areum514/homeIotSystem/README.md

# homeIotSystem
주제: 화재, 도난, 일산화탄소 등을 여러가지 센서들을 이용한 홈아이오티 시스템 구축
