areum514/homeIotSystem/final_.pptx

2019년도 2학기: IoT 시스템 설계

무선 종합 경보기

하드웨어: 김민수, 김태연
현관 모듈: 추교찬, 이아름
침실 모듈: 한찬솔, 이경민, 유현아

## Slide 2

CONTENTS

00 01 02 03

개요

- 문제 정의
- 전체 구성
- 데이터 교환 형식
<JSON>

Level 1

- 동작환경
- 구성
- 동작방법

Level 2

- 동작환경
- 구성
- 동작방법

Level 3

- 동작환경
- 구성
- 동작방법

## Slide 3

IoT 시스템 설계 – 무성 종합 경보기

00

개요

## Slide 4

(1) 문제 정의

00

IoT 시스템 설계 – 무성 종합 경보기

북한 건물 내부에서
각종 위험 상황들을 감지하고
사용자에게 전파할 수 있는
시스템의 구축

## Slide 5

(2) 전체 구성

00

IoT 시스템 설계 – 무성 종합 경보기

MQTT

Hass

Raspberry Pi3

IFTTT

AP

Internet

NodeMCU #1
<거실, Room1>

문 열림 감지 센서, 불꽃 감지 센서, Button, LED, Buzzer

NodeMCU #2
<침실, Room2>

온습도 센서, 가스 센서, LCD, LED, Button, Buzzer

Notes: ‘NodeMCU #2’ 역시 ‘NodeMCU #1’과 동일하게 외출 모드 ON/OFF 하기 위해 Button을 추가하였다.

## Slide 6

(3) 데이터 교환 형식
webhook

00

IoT 시스템 설계 – 무성 종합 경보기

#define WEBHOOK_PROTOCOL "http://"

WEBHOOK_PROTOCOL 과 각각의 아이피틑 다음과 같이 정의 됩니다.
#define WEBHOOK_PROTOCOL "http://"

#define NODE2_IP “#.#.#.#”

#define NODE1_IP “#.#.#.#”

센서 | 변수
문 열림 감지 센서 | #define WEBHOOK_PATH_DOOROPEN WEBHOOK_PROTOCOL NODE2_IP "/DoorOpen/"
불꽃 감지 센서 | #define WEBHOOK_PATH_FLAME WEBHOOK_PROTOCOL NODE2_IP "/Flame/"
가스 센서 | #define WEBHOOK_PATH_GAS WEBHOOK_PROTOCOL NODE1_IP "/Gas/"
온도 센서 | #define WEBHOOK_PATH_TEMP WEBHOOK_PROTOCOL NODE1_IP "/Temperature/"
습도 센서 | #define WEBHOOK_PATH_HUMIDITY WEBHOOK_PROTOCOL NODE1_IP "/Humidity/”

Notes: #define WEBHOOK_PROTOCOL "http://"
#define NODE2_IP “#.#.#.#”

#define WEBHOOK_PROTOCOL "http://"
#define NODE1_IP "192.168.0.104"
" #define WEBHOOK_PATH_TEMP WEBHOOK_PROTOCOL NODE1_IP "/Temperature/" #define WEBHOOK_PATH_GAS WEBHOOK_PROTOCOL NODE1_IP "/Gas/"

#define WEBHOOK_PROTOCOL "http://"
#define NODE1_IP "192.168.0.104"

#define WEBHOOK_PATH_TEMP WEBHOOK_PROTOCOL NODE1_IP "/Temperature/"
#define WEBHOOK_PATH_GAS WEBHOOK_PROTOCOL NODE1_IP "/Gas/"

## Slide 7

IoT 시스템 설계 – 무성 종합 경보기

01

LEVEL

## Slide 8

LEVEL 1

01

IoT 시스템 설계 – 무성 종합 경보기

MQTT

Hass

Raspberry Pi3

IFTTT

AP

Internet

NodeMCU #1
<거실, Room1>

문 열림 감지 센서
불꽃 감지 센서

NodeMCU #2
<침실, Room2>

온습도 센서
가스 센서

Notes: 상황: 공유기 X, 인터넷 X
구성: NodeMCU 2개
동작 방식: 각 모듈이 독립적으로 동작

## Slide 9

NodeMCU #1: 메시지 포맷

01

IoT 시스템 설계 – 무성 종합 경보기

센서 | | lcd 화면에 출력되는 내용
문 열림 감지 센서 | 열림 | “DOOR OPEN!!”
| 닫힘 | "DOOR closed"
불꽃 감지 센서 | 감지 O | "FLAME undetected"
| 감지 X | "FLAME detected!"
푸시 버튼 | 사람 有 (외출모드X) | "Now inside. ***"
| 사람 無 (외출모드O) | "Now outside. ***"

Notes: #define DOOR_OPEN_MSG "DOOR OPEN!!"
#define DOOR_CLOSED_MSG "DOOR closed"
#define FLAME_UNDETECTED_MSG "FLAME undetected"
#define FLAME_DETECTED_MSG "FLAME detected!"

## Slide 10

NodeMCU #1: 불꽃 감지 센서 메시지에 의한 컴포넌트 동작(LED, Buzzer)

센서 상태 | | Description
| | 외출 모드 OFF (사람 有) | | 외출 모드 ON (사람 無)
| | LED | Buzzer | LED | Buzzer
문열림 | Detected | ON | Buzzer mode1: tone(Buzzer, 262, 100); | ON | Buzzer mode1: tone(Buzzer, 262, 100);
| Undetcted | OFF | OFF | OFF | OFF
화재 | Detected | ON | Buzzer mode2: tone(Buzzer, 131, 100); tone(Buzzer, 262, 100); 0.5초 주기로 5동안 | ON | Buzzer mode2: tone(Buzzer, 131, 100); tone(Buzzer, 262, 100); 0.5초 주기 10동안
| Undetcted | OFF | OFF | OFF | OFF
동시에 | Detected | ON | Buzzer mode3: tone(Buzzer, 131, 100); tone(Buzzer, 262, 100); 0.2초 주기로 5동안 | ON | Buzzer mode3: tone(Buzzer, 131, buzzerinterval); tone(Buzzer, 262, buzzerinterval); 0.2초 주기로 10동안
| Undetcted | OFF | OFF | OFF | OFF

01

IoT 시스템 설계 – 무성 종합 경보기

Notes: ※ 외출 모드 OFF(사람 有)에는 ‘쿠킹 모드 ON’과 ‘쿠킹 모드 OFF’ 두 가지 경우로 나누어진다. ‘쿠킹 모드 ON’의 경우, 불꽃이 감지되면 LED가 켜지고 Buzzer는 1분마다 들어오는 메시지가 1시간동안 계속해서 {“RoomLocation”: value, FlameFlagState”: ”FlameFlagON”}일 때 3옥타브 ‘도’와 4옥타브 ‘도’를 0.5초 주기로 반복하여 출력한다. (중간에 한번이라도 {“RoomLocation”: (동일한) value, FlameFlagState”: “FlameFlagOFF”}가 들어오면 시간을 reset한다.) LED와 Buzzer는 {“RoomLocation”: (동일한) value, FlameFlagState”: “FlameFlagOFF”} 메시지가 수신되면 꺼진다.
※ 외출 모드 OFF(사람 有)이면서 ‘쿠킹 모드 OFF’일 때는 {“RoomLocation”: value, FlameFlagState”: ”FlameFlagON”}가 들어오면 바로 LED와 함께 Buzzer에서 소리가 출력된다. 이 역시 {“RoomLocation”: (동일한) value, FlameFlagState”: “FlameFlagOFF”} 메시지가 수신되면 꺼진다.
※ 외출 모드 ON (사람 無)에는 {“RoomLocation”: value, FlameFlagState”: ”FlameFlagON”} 메시지가 들어오면 LED는 계속 OFF된 상태로 있지만 Buzzer는 {“RoomLocation”: value, FlameFlagState”: ”FlameFlagON”} 이 들어온 시간부터 5분 동안 3옥타브 ‘도’와 4옥타브 ‘도’를 0.5초 주기로 반복하여 출력한다. 🡪 주변 사람들에게 집 안에서 문제가 발생했다는 것을 알리기 위함이다.

## Slide 11

NodeMCU #2: 메시지 포맷

센서 | | lcd 화면에 출력되는 내용
온습도 센서 | | display.print("Temp: "); display.print(temperature,1); display.println(" *C"); display.print("Hum: "); display.print(humidity,1); display.println(" %");
가스 센서 | LOW (150 미만) | display.println("GAS Detected!"); display.print("GAS: "); display.println(GAS_value); display.print("Normal < "); display.println(GAS_MIDDLE);
| MIDDLE (250 이상 350 미만)
| HIGH (350 이상)
푸시 버튼 | 사람 有 (외출모드X) | {“RoomLocation”: Room2, LeavingState”: “LeavingModeOFF”}
| 사람 無 (외출모드O) | {“RoomLocation”: Room2, LeavingState”: “LeavingModeON”}

01

IoT 시스템 설계 – 무성 종합 경보기

※ 가스 측정 데이터의 범위 설정 및 Level 설정: 150 미만=LOW, 150 이상 450 미만=MIDDLE, 450 이상=HIGH

Notes: ※ 가스 측정 데이터의 범위 설정 및 Level 설정
150 미만: LOW, 150 이상 450 미만: MIDDLE, 450 이상: HIGH

## Slide 12

NodeMCU #2: 메시지 확인 주기 (전송 X)

01

IoT 시스템 설계 – 무성 종합 경보기

컴포넌트 | 버튼이 눌러졌을 때 (눌러지지 않았을 때는 메시지 확인 X)
푸시 버튼 | No delay (버튼이 눌러지면 무조건 toggle)

센서 | 외출 모드 OFF (사람 O) | 외출 모드 ON (사람 X)
온습도 센서 | 5분 | 15분
가스 센서 | 1초 | 1초

NodeMCU #2
<침실, Room2>

메시지 확인

Notes: NodeMCU #2 자체적으로 조건을 판별하여 컴포넌트의 동작을 제어하는 주기는 위와 같이 설정한다.
AP가 없기에 메시지 데이터를 확인하여 출력을 갱신하여도 실제로 이것이 전송되지는 못한다.
level 2와 level 3에서도 같은 주기로 메시지를 확인하여 출력 데이터를 갱신한다.

## Slide 13

NodeMCU #2: 푸시 버튼 메시지의 의한 모드 변경

01

IoT 시스템 설계 – 무성 종합 경보기

메시지 종류 | Description
{“RoomLocation”: value, LeavingState”: “LeavingModeON”} | 외출 모드 ON
{“RoomLocation”: value, LeavingState”: “LeavingModeOFF”} | 외출 모드 OFF

## Slide 14

NodeMCU #2: 온습도 센서와 가스 센서 메시지에 의한 LED, Buzzer 동작

01

IoT 시스템 설계 – 무성 종합 경보기

메시지 종류 | | Description
| | 외출 모드 OFF | | 외출 모드 ON
| | LED | Buzzer | LED | Buzzer
{“RoomLocation”: value, ”Temperature”: value: “Humidity”: value} | | OFF | OFF | OFF | OFF
{“RoomLocation”: value, “GasValue”: value} | LOW | OFF | OFF | OFF | OFF
{“RoomLocation”: value, “GasValue”: value} | MIDDLE | ON | ON (3옥타브 도) | OFF | OFF
{“RoomLocation”: value, “GasValue”: value} | HIGH | ON | ON(4옥타브 도) | OFF | OFF

Notes: ※ {“RoomLocation”: value, “GasValue”: value} (150 이상의 value) 메시지에 의해 LED와 Buzzer가 ON되는 경우, {“RoomLocation”: (동일한) value, “GasValue”: value} (150 미만의 value) 메시지가 수신될 때까지 꺼지지 않는다.
※ {“RoomLocation”: value, “GasValue”: value}의 가스 측정 데이터에 따라 Buzzer에서 다른 종류의 소리가 나도록 한다. 음계는 일반 사람들이 구분하기 힘들기 때문에 소리의 주기로 결정한다. (2초 주기로 4옥타브 ‘도’ ON/OFF 반복해서 출력하면 ‘MIDDLE’ 상태이며, 0.3초마다 4옥타브 ‘도’의 ON/OFF를 반복하며 출력하면 ‘HIGH’ 상태이다.)

## Slide 15

NodeMCU #2: 푸시 버튼 메시지에 의한 LCD 동작

01

IoT 시스템 설계 – 무성 종합 경보기

메시지 종류 | Description
| LCD
{“RoomLocation”: value, LeavingState”: “LeavingModeON”} | 첫 번째 줄: 위치정보 (String) 두 번째 줄: “Leav. Mode On” | 5초 출력 후 꺼짐
{“RoomLocation”: value, LeavingState”: “LeavingModeOFF”} | 첫 번째 줄: 위치정보 (String) 두 번째 줄: “Leav. Mode Off” | 5초 출력 후 온습도

Notes: ※ {“RoomLocation”: value, LeavingState”: “LeavingModeON”}에 의해서 5초 동안 위치정보와 “Leaving Mode On” 메시지가 LCD에 출력된 다음, LCD 화면이 꺼진다. (사람 無)

※ {“RoomLocation”: value, LeavingState”: “LeavingModeOFF”}에 의해서 5초 동안 위치정보와 “Leaving Mode Off” 메시지가 LCD에 출력된 다음, 기본적으로 위치정보와 온습도 데이터가 LCD에 출력된다.

## Slide 16

NodeMCU #2: 온습도 센서와 가스 센서 메시지에 의한 LCD 동작

01

IoT 시스템 설계 – 무성 종합 경보기

메시지 종류 | | Description
| | 외출 모드 OFF (사람 有) | 외출 모드 ON (사람 無)
| | LCD | LCD
{“RoomLocation”: value, ”Temperature”: value: “Humidity”: value} 온도 데이터: .1f (자료형 float, 소수점 첫째 자리) 습도 데이터: .1f (자료형 float, 소수점 첫째 자리) | | 첫 번째 줄: 위치정보 (String) 두 번째 줄: “Temp. : 온도 ℃(소수점 첫째자리 float)” 세 번째 줄: “Hum. : 습도 %(소수점 첫째자리 float)” 네 번째 줄: “Leaving mode: OFF” | 출력 안함
{“RoomLocation”: value, “GasValue”: value} 가스 측정 데이터 자료형: integer | LOW | 첫 번째 줄: 위치정보 (String) 두 번째 줄: “Temp. : 온도 ℃ (소수점 첫째자리 float)” 세 번째 줄: “Hum. : 습도 %(소수점 첫째자리 float)”
{“RoomLocation”: value, “GasValue”: value} 가스 측정 데이터 자료형: integer | MIDDLE | 첫 번째 줄: 위치정보 (String) 두 번째 줄: “Gas is detected!” 세 번째 줄: “Gas: 측정 값(Integer)” 네 번째 줄: “Normal < 250”
{“RoomLocation”: value, “GasValue”: value} 가스 측정 데이터 자료형: integer | HIGH

## Slide 17

IoT 시스템 설계 – 무성 종합 경보기

02

LEVEL

## Slide 18

LEVEL 2

02

IoT 시스템 설계 – 무성 종합 경보기

MQTT

Hass

Raspberry Pi3

IFTTT

AP

Internet

NodeMCU #1
<거실, Room1>

문 열림 감지 센서
불꽃 감지 센서

Local Network

Webhook
HTTP GET CALLBACK

NodeMCU #2
<침실, Room2>

온습도 센서
가스 센서

Notes: 상황: 공유기 O, 인터넷 X
구성: 공유기, NodeMCU 2개
동작 방식: 공유기가 AP로 동작하여 Local network 형성
통신 방식: Webhook 으로 node간 통신
특징: 각 노드가 외부(상대 노드) 컴포넌트로부터 데이터를 읽어 와서 이를 출력한다.
==========================================================
정의 : Webhooks are "user-defined HTTP callbacks". They are usually triggered by some event, such as pushing code to a repository or a comment being posted to a blog.

한 마디로 사용자 정의 HTTP 메소드 콜백

Level 2 에서는 HTTP GET 콜백을 정의하여 노드가 서로 통신하게 됨

## Slide 19

Webhook을 이용한 Node 1, 2 통신 방법

02

IoT 시스템 설계 – 무성 종합 경보기

AP

Local Network

Webhook
HTTP GET CALLBACK

NodeMCU #1
<거실, Room1>
IP: 100.100.100.100

문 열림 감지 센서
불꽃 감지 센서

[Node 1 의 센서 감지 상황을 전달받기 위해]
- http://100.100.100.200/DoorOpen/{위치정보}
- http://100.100.100.200/Flame/{위치정보}

NodeMCU #2
<침실, Room2>
IP: 100.100.100.200

온습도 센서
가스 센서

[Node 2 의 센서 감지 상황을 전달받기 위해]
- http://100.100.100.100/Humidity/{위치정보}
- http://100.100.100.100/Temperature/{위치정보}
- http://100.100.100.100/Gas/{위치정보}

## Slide 20

NodeMCU #1,#2: 메시지 포맷 <Webhook 링크 호출>

02

IoT 시스템 설계 – 무성 종합 경보기

#define WEBHOOK_PROTOCOL "http://"

WEBHOOK_PROTOCOL 과 각각의 아이피틑 다음과 같이 정의 됩니다.
#define WEBHOOK_PROTOCOL "http://"

#define NODE2_IP “#.#.#.#”

#define NODE1_IP “#.#.#.#”

센서 | 변수
문 열림 감지 센서 | #define WEBHOOK_PATH_DOOROPEN WEBHOOK_PROTOCOL NODE2_IP "/DoorOpen/"
불꽃 감지 센서 | #define WEBHOOK_PATH_FLAME WEBHOOK_PROTOCOL NODE2_IP "/Flame/"
가스 센서 | #define WEBHOOK_PATH_GAS WEBHOOK_PROTOCOL NODE1_IP "/Gas/"
온도 센서 | #define WEBHOOK_PATH_TEMP WEBHOOK_PROTOCOL NODE1_IP "/Temperature/"
습도 센서 | #define WEBHOOK_PATH_HUMIDITY WEBHOOK_PROTOCOL NODE1_IP "/Humidity/”

센서 | 변수
문 열림 감지 센서 | #define WEBHOOK_PATH_DOOROPEN WEBHOOK_PROTOCOL NODE2_IP "/DoorOpen/"
불꽃 감지 센서 | #define WEBHOOK_PATH_FLAME WEBHOOK_PROTOCOL NODE2_IP "/Flame/"
가스 센서 | #define WEBHOOK_PATH_GAS WEBHOOK_PROTOCOL NODE1_IP "/Gas/"
온도 센서 | #define WEBHOOK_PATH_TEMP WEBHOOK_PROTOCOL NODE1_IP "/Temperature/"
습도 센서 | #define WEBHOOK_PATH_HUMIDITY WEBHOOK_PROTOCOL NODE1_IP "/Humidity/”

Notes: #define WEBHOOK_PROTOCOL "http://"
#define NODE2_IP “#.#.#.#”

#define WEBHOOK_PROTOCOL "http://"
#define NODE1_IP "192.168.0.104"
" #define WEBHOOK_PATH_TEMP WEBHOOK_PROTOCOL NODE1_IP "/Temperature/" #define WEBHOOK_PATH_GAS WEBHOOK_PROTOCOL NODE1_IP "/Gas/"

#define WEBHOOK_PROTOCOL "http://"
#define NODE1_IP "192.168.0.104"

#define WEBHOOK_PATH_TEMP WEBHOOK_PROTOCOL NODE1_IP "/Temperature/"
#define WEBHOOK_PATH_GAS WEBHOOK_PROTOCOL NODE1_IP "/Gas/"

## Slide 21

NodeMCU #1: 메시지 포맷 <Webhook 링크 호출>

http://100.100.100.200/****/{위치정보}

센서 | | 생성되는 메시지 (스트링) | 예시
문 열림 감지 센서 | 열림 /DoorOpen/ | {“RoomLocation”: value, DoorState”: ”DoopOpen”} | {“RoomLocation”: Room1, DoorState”: ”DoopOpen”}
| 닫힘 | {“RoomLocation”: value, DoorState”: ”DoorClose”} | {“RoomLocation”: Room1, DoorState”: ”DoorClose”}
불꽃 감지 센서 | 감지 O /Flame/ | {“RoomLocation”: value, FlameFlagState”: ”FlameFlagON”} | {“RoomLocation”:Room1, FlameFlagState”: ”FlameFlagON”}
| 감지 X | {“RoomLocation”: value, FlameFlagState”: “FlameFlagOFF”} | {“RoomLocation”: Room1, FlameFlagState”: “FlameFlagOFF”}
푸시 버튼 | 사람 有 (외출모드X) | {“RoomLocation”: value, LeavingState”: “LeavingModeOFF”} | {“RoomLocation”: Room1, LeavingState”: “LeavingModeOFF”}
| 사람 無 (외출모드O) | {“RoomLocation”: value, LeavingState”: “LeavingModeON”} | {“RoomLocation”: Room1, LeavingState”: “LeavingModeON”}
| 쿠킹모드 O | {“RoomLocation”: value, CookingState”: “CookingModeON”} | {“RoomLocation”: Room1, CookingState”: “CookingModeON”}
| 쿠킹모드 X | {“RoomLocation”: value, CookingState”: “CookingModeOFF”} | {“RoomLocation”: Room1, CookingState”: “CookingModeOFF”}

02

IoT 시스템 설계 – 무성 종합 경보기

## Slide 22

NodeMCU #2: 메시지 포맷 <Webhook 링크 호출>

http://100.100.100.100/****/{위치정보}

센서 | | 생성되는 메시지 (스트링) | 예시
온습도 센서 /Temperature/ /Humidity/ | | {“RoomLocation”: value, ”Temperature”: value: “Humidity”: value} 온도 데이터: .1f (자료형 float, 소수점 첫째 자리) 습도 데이터: .1f (자료형 float, 소수점 첫째 자리) | {“RoomLocation”: Room2, “Temperature”: 27.5: “Humidity”: 46.3}
가스 센서 /Gas/ | LOW (150 미만) | {“RoomLocation”: value, “GasValue”: value} 가스 측정 데이터 자료형: integer | {“RoomLocation”: Room2, “GasValue”: 38}
| MIDDLE (250 이상 350 미만) | {“RoomLocation”: value, “GasValue”: value} 가스 측정 데이터 자료형: integer | {“RoomLocation”: Room2, “GasValue”: 180}
| HIGH (350 이상) | {“RoomLocation”: value, “GasValue”: value} 가스 측정 데이터 자료형: integer | {“RoomLocation”: Room2, “GasValue”: 350}
푸시 버튼 | 사람 有 (외출모드X) | {“RoomLocation”: value, LeavingState”: “LeavingModeOFF”} | {“RoomLocation”: Room2, LeavingState”: “LeavingModeOFF”}
| 사람 無 (외출모드O) | {“RoomLocation”: value, LeavingState”: “LeavingModeON”} | {“RoomLocation”: Room2, LeavingState”: “LeavingModeON”}

02

IoT 시스템 설계 – 무성 종합 경보기

※ 가스 측정 데이터의 범위 설정 및 Level 설정: 150 미만=LOW, 150 이상 450 미만=MIDDLE, 450 이상=HIGH

Notes: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

## Slide 23

NodeMCU #1: 메시지 확인 및 전송 주기

02

IoT 시스템 설계 – 무성 종합 경보기

컴포넌트 | 버튼이 눌러졌을 때 (눌러지지 않았을 때는 메시지 확인 X)
푸시 버튼 | 1초

센서 | 외출 모드 OFF (사람 有) | 외출 모드 ON (사람 無)
문 열림 감지 센서 | 10초 | 1초

센서 | 쿠킹 모드 ON & 외출 모드 OFF | 쿠킹 모드 OFF & 외출 모드 OFF | 외출 모드 ON (자동으로 쿠킹 모드 OFF)
불꽃 감지 센서 | 1분 | 1분 | 30초

NodeMCU #1
<거실, Room1>
IP: 100.100.100.100

메시지 확인 및 전송

Notes: 메시지 확인 및 전송 주기 (NodeMCU #1와 NodeMCU #2 두 가지 모듈의 동작 제어를 위해
메시지를 확인하고 전송함)

※ Level 1에서의 주기와 같다. bottom-top 형태로 level2와 3에서도 계속해서 유지된다.
※ Level 2에서는 level 1의 기능에 주기마다 메시지를 전송하는 기능이 추가된다.

## Slide 24

NodeMCU #1: NodeMCU #2의 푸시 버튼 메시지에 의한 모드 설정 <내부 메시지에 의한 동작은 Level1 유지>

외출 모드 제어가 NodeMCU #1, #2를 가리지 않고 버튼 및 메시지를 통해 가능

02

IoT 시스템 설계 – 무성 종합 경보기

메시지 종류 | Description
{“RoomLocation”: value, LeavingState”: “LeavingModeON”} | 외출 모드 ON
{“RoomLocation”: value, LeavingState”: “LeavingModeOFF”} | 외출 모드 OFF

NodeMCU #1
<거실, Room1>
IP: 100.100.100.100

## Slide 25

NodeMCU #1: NodeMCU #2의 가스 센서 메시지에 의한 모드 설정 <내부 메시지에 의한 동작은 Level1 유지>

02

IoT 시스템 설계 – 무성 종합 경보기

메시지 종류 | | Description
| | 외출 모드 OFF | | 외출 모드 ON
| | LED | Buzzer | LED | Buzzer
{“RoomLocation”: value, ”Temperature”: value: “Humidity”: value} | | OFF | OFF | OFF | OFF
{“RoomLocation”: value, “GasValue”: value} | LOW | OFF | OFF | OFF | OFF
{“RoomLocation”: value, “GasValue”: value} | MIDDLE | ON | ON (3옥타브 도) | OFF | OFF
{“RoomLocation”: value, “GasValue”: value} | HIGH | ON | ON(4옥타브 도) | OFF | OFF

NodeMCU #1
<거실, Room1>
IP: 100.100.100.100

온습도는 의미 없으므로 제외

Notes: ※ 데이터 포맷은 NodeMCU #2 데이터 포맷 (15page) 참조
※ NodeMCU #1가 전달 받는 온습도 메시지는 의미가 없기 때문에 제외시킴.
※ 전체동작은 Level1에서 NodeMCU #2의 LED, Buzzer 동작과 동일

## Slide 26

NodeMCU #2: 메시지 확인 및 전송 주기

02

IoT 시스템 설계 – 무성 종합 경보기

컴포넌트 | 버튼이 눌러졌을 때 (눌러지지 않았을 때는 메시지 확인 X)
푸시 버튼 | No delay (버튼이 눌러지면 무조건 toggle)

센서 | 외출 모드 OFF (사람 O) | 외출 모드 ON (사람 X)
온습도 센서 | 5분 | 15분
가스 센서 | 1초 | 1초

NodeMCU #2
<침실, Room2>
IP: 100.100.100.200

메시지 확인 및 전송

Notes: 메시지 확인 및 전송 주기 (NodeMCU #1와 NodeMCU #2 두 가지 모듈의 동작 제어를 위해
메시지를 확인하고 전송함)

※ Level 1에서의 주기와 같다. bottom-top 형태로 level2와 3에서도 계속해서 유지된다.
※ Level 2에서는 level 1의 기능에 주기마다 메시지를 전송하는 기능이 추가된다.

## Slide 27

NodeMCU #2: NodeMCU #1의 푸시 버튼 메시지에 의한 모드 설정

02

IoT 시스템 설계 – 무성 종합 경보기

외출 모드 제어가 NodeMCU #2, #1을 가리지 않고 버튼 및 메시지를 통해 가능

메시지 종류 | Description
{“RoomLocation”: value, LeavingState”: “LeavingModeON”} | 외출 모드 ON
{“RoomLocation”: value, LeavingState”: “LeavingModeOFF”} | 외출 모드 OFF

NodeMCU #2
<침실, Room2>
IP: 100.100.100.200

Notes: ※ NodeMCU #2의 버튼 뿐만 아니라 NodeMCU #1의 버튼에 의해서 외출모드가 설정될 수 있음을 의미한다.
위의 예시를 통해 NodeMCU #1의 메시지로 NodeMCU #2의 외출 모드가 설정될 수 있음을 알 수 있다.

## Slide 28

NodeMCU #2: NodeMCU #1에서 오는 문 열림 센서 메시지에 의한 컴포넌트 동작 (LED, Buzzer)

02

IoT 시스템 설계 – 무성 종합 경보기

메시지 종류 | Description
| 외출 모드 OFF (사람 有) | | | 외출 모드 ON (사람 無)
| LED | Buzzer | | LED | Buzzer
{“RoomLocation”: value, DoorState”: ”DoopOpen”} | ON | 문 열림 시간 20분 미만 | OFF | OFF | OFF
| | 문 열림 시간 20분 이상 | ON
{“RoomLocation”: value, DoorState”: ”DoorClose”} | OFF | OFF | | OFF | OFF

NodeMCU #2
<침실, Room2>
IP: 100.100.100.200

침실이므로 경보 필요 없음

Notes: ※ 외출 모드 OFF(사람 有)에는 {“RoomLocation”: value, DoorState”: ”DoopOpen”} 메시지에 의해 LED와 Buzzer가 ON되는 경우, {“RoomLocation”: (동일한) value, DoorState”: ”DoorClose”} 메시지가 수신될 때까지 꺼지지 않는다.
※ NodeMCU #1의 경우에는 외출 모드 ON(사람 無)에는 {“RoomLocation”: value, DoorState”: ”DoopOpen”} 메시지에 의해 LED와 Buzzer가 ON되어 1분 동안 작동(경고 목적)하도록 했지만, NodeMCU #2는 침실이므로 굳이 LED와 Buzzer가 작동할 필요 없다.

## Slide 29

NodeMCU #2: NodeMCU #1에서 오는 불꽃 감지 센서 메시지에 의한 컴포넌트 동작 (LED, Buzzer)

Buzzer: 3 옥타브 ‘도’ 및 4 옥타브 ‘도’ 를 0.5초 주기로 반복하여 출력

02

IoT 시스템 설계 – 무성 종합 경보기

메시지 종류 | Description
| 외출 모드 OFF (사람 有) | | | | | 외출 모드 ON (사람 無)
| 쿠킹 모드 ON | | | 쿠킹 모드 OFF
| LED | Buzzer | | LED | Buzzer | LED | Buzzer
{“RoomLocation”: value, FlameFlagState”: ”FlameFlagON”} | ON | 불꽃 감지 시간 1시간 미만 | OFF | ON | ON | OFF | OFF
| | 불꽃 감지 시간 1시간 이상 | ON
{“RoomLocation”: value, FlameFlagState”: “FlameFlagOFF”} | OFF | OFF | | OFF | OFF | OFF | OFF

NodeMCU #2
<침실, Room2>
IP: 100.100.100.200

침실이므로 경보 역할 불가

Notes: ※ 전체동작은 NodeMCU #1과 비슷하게 동작, 14 page 참고
※ 메시지 포맷은 NodeMCU #1의 메시지 포맷 참고 (10 page)
※ 외출 모드 ON (사람 無)에는 {“RoomLocation”: value, FlameFlagState”: ”FlameFlagON”} 메시지가 들어오면 NodeMCU #1에서는 Buzzer를 울렸지만, NodeMCU #2는 침실이기 때문에 Buzzer를 울려서 주변 사람들에게 상황을 전파하는 역할을 할 수 없다. 고로 해당기능을 OFF 시켰다.

## Slide 30

NodeMCU #2: NodeMCU #1에서 오는 메시지에 의한 컴포넌트 동작 (LCD)

02

IoT 시스템 설계 – 무성 종합 경보기

메시지 종류 | Description
| LCD
{“RoomLocation”: value, LeavingState”: “LeavingModeON”} | 첫 번째 줄: 위치정보 (String) 두 번째 줄: “Leaving Mode On” | 5초 출력 후 꺼짐
{“RoomLocation”: value, LeavingState”: “LeavingModeOFF”} | 첫 번째 줄: 위치정보 (String) 두 번째 줄: “Leaving Mode Off” | 5초 출력 후 온습도

NodeMCU #1
<거실, Room1>
IP: 100.100.100.100

NodeMCU #2
<침실, Room2>
IP: 100.100.100.200

Notes: ※ {“RoomLocation”: value, LeavingState”: “LeavingModeON”}에 의해서 10초 동안 위치정보와 “Leaving Mode On” 메시지가 LCD에 출력된 다음, LCD 화면이 꺼진다. (사람 無)

※ {“RoomLocation”: value, LeavingState”: “LeavingModeOFF”}에 의해서 10초 동안 위치정보와 “Leaving Mode Off” 메시지가 LCD에 출력된 다음, 기본적으로 위치정보와 온습도 데이터가 LCD에 출력된다.

## Slide 31

NodeMCU #2: NodeMCU #1에서 오는 메시지에 의한 컴포넌트 동작(LCD)

메시지 종류 | Description
| 외출 모드 OFF (사람 有) | 외출 모드 ON
| LCD | LCD
{“RoomLocation”: value, DoorState”: ”DoopOpen”} | 첫 번째 줄: 위치정보 (String) 두 번째 줄: “Door is open!” 네 번째 줄: “Leaving mode: OFF” | 출력 안함
{“RoomLocation”: value, DoorState”: ”DoorClose”} | 첫 번째 줄: 위치정보 (String) 두 번째 줄: “Temperature: 온도(소수점 첫째자리 float)” 세 번째 줄: “Humidity: 습도(소수점 첫째자리 float)” 네 번째 줄: “Leaving mode: OFF”
{“RoomLocation”: value, FlameFlagState”: ”FlameFlagON”} | 첫 번째 줄: 위치정보 (String) 두 번째 줄: “Flame is detected!” 네 번째 줄: “Leaving mode: OFF”
{“RoomLocation”: value, FlameFlagState”: “FlameFlagOFF”} | 첫 번째 줄: 위치정보 (String) 두 번째 줄: “Temperature: 온도(소수점 첫째자리 float)” 세 번째 줄: “Humidity: 습도(소수점 첫째자리 float)” 네 번째 줄: “Leaving mode: OFF”

02

IoT 시스템 설계 – 무성 종합 경보기

## Slide 32

IoT 시스템 설계 – 무성 종합 경보기

03

LEVEL

## Slide 33

03

Broker

LEVEL 3

IoT 시스템 설계 – 무성 종합 경보기

MQTT

Hass

Subscriber

Raspberry Pi3

Topic

IFTTT

AP

Internet

Internet

Publisher

Publisher

NodeMCU #1
<거실, Room1>

문 열림 감지 센서
불꽃 감지 센서

NodeMCU #2
<침실, Room2>

온습도 센서
가스 센서

Notes: ‘NodeMCU #2’ 역시 ‘NodeMCU #1’과 동일하게 외출 모드 ON/OFF 하기 위해 Button을 추가하였다.
=====================================
node(publish data)
-> raspberrypi(broker)
-> HASS(subscribe&receive data)

Publisher 🡪 nodeMCU (정보를 만들어 내는 곳)
Broker 🡪 Rpi3 (정보를 중계하는 곳)
Subscriber 🡪 Hass (정보를 사용하는 곳)

PI IP에서 broker를 형성하여, node와 HASS간 데이터 전송을 주관한다.
Node 1, 2 각각 자신의 인터넷 연결 상태를 우선적으로 mqttbroker에 publish*한다.
이후, 자신의 데이터 확인 주기마다 mqtt broker에 publish한다.
HASS로 publish할 topic: data는 *39page*와 같이 구성한다.

## Slide 34

IFTTT: 전송 – 코드 설계

03

IoT 시스템 설계 – 무성 종합 경보기

Func: send_event(“Message”)

사고 상황 | 함수 | 알림
Door | send_event(“DoorFlaagon”) | DoorOpen = HIGH
Flame | Send_event (“FlameFlagon”) | FlamgeFlagOn = HIGH
Gas | Send_event(“GasFlagon”) | GasValue > 450

Notes: Send_event(“메시지”) 형태로 함수 만들어줌
전송된 json data의 두번째 value를 파라미터로 바로 passing 해준다.
가스의 경우 GasValue의 키 값이 450이상이면 알림이 울리게 내부에서 설정해준다
Ex)
도난 감지: Send_event (“DoorOpen”)
화재 감지: Send_event (“FlameFlagon”)
가스 감지: Send_event(“GasFlagon”)

## Slide 35

IFTTT: 전송 – 시간 조건 및 결과

03

IoT 시스템 설계 – 무성 종합 경보기

사고 상황 | Leaving mode: ON | Leaving mode: OFF
| 3분 마다 | 10분 마다
Gas | “가스 가 감지되었습니다.”
Door | “문열림이 감지되었습니다.”
Flame | “화재가 감지되었습니다.”

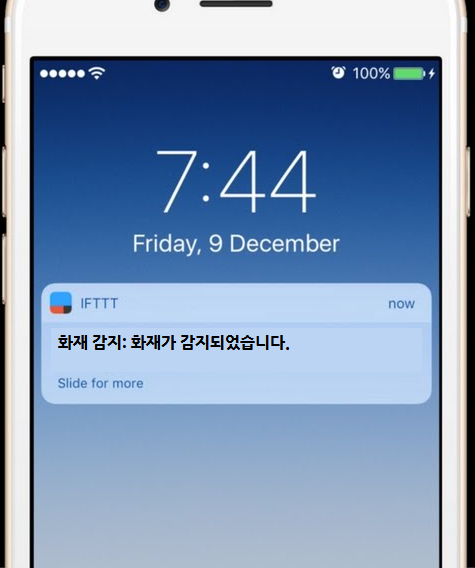
[picture p22: figure]

IFTTT

Notification

Notes: Buzzer/LED와 반대로, IFTTT는 외출 시 원격으로 사고 상황을 전달하는 것에 중점을 두기에 leaving mode: ON 일 경우 신호가 바뀔 때까지 3분마다 notification을 전송하여 상황을 전달한다.
아래 표는 send_event(“사고상황”)를 행하는 주기이다. 사고 상황이 HIGH가 지속되는 경우 해당 주기마다 notification을 전송한다.

## Slide 36

MQTT: topic

03

IoT 시스템 설계 – 무성 종합 경보기

Hass에서 switch를 만들어 LED와 Buzzer의 상태를 임의적으로 바꿀 수 있도록 함

Topics | nodeMCU #1 (publish) | nodeMCU #2 (publish) | HASS (subscribe)
topic (dht22_t) | X | myhome/room2/dht22_t | myhome/room2/dht22_t
topic (dht22_h) | X | myhome/room2/dht22_h | myhome/room2/dht22_h
topic (gas) | X | myhome/room2/gas | myhome/room2/gas
topic (door) | myhome/room1/door | x | myhome/room1/door
topic (Flame) | myhome/room1/flame | x | myhome/room1/flame
topic (wifi) | myhome/room1/wifi | myhome/room2/wifi | myhome/room1/wifi myhome/room2/wifi2

Topics | NodeMCU #1 (subscribe) | NodeMCU #2 (subscribe) | HASS(publish)
topic (LED/BUZZER) | myhome | myhome | myhome

## Slide 37

MQTT: HASS에서 publish하는 data

03

IoT 시스템 설계 – 무성 종합 경보기

Switch

Name == “LED”

Name == “Buzzer”

“ledon”
“ledoff”

Payload_on
Payload_off

“buzzeron”
“buzzeroff”

## Slide 38

MQTT: NodeMCU에서 publish하는 data

03

IoT 시스템 설계 – 무성 종합 경보기

Location | Message | DataType
NodeMCU #2 | myhome/room2/dht22_t: {temperature} | Float
| myhome/room2/dht22_h: {humidity} | Float
| myhome/room2/gas: {“Gas detected” or Gas undetected} | String
NodeMCU #1 | myhome/room1/door: {“DOOR Open” or “DOOR closed”} | String
| myhome/room1/flame: {“FLAME detected” or “FLAME undetectedf”} | String
AP | myhome/wifi: {“WIFI On” or “WIFI OFF”} myhome/wif2:{“WIFI On” or “WIFI OFF”} | String

Notes: - mqtt publish 할 때에는 위치 정보를 따로 value로 보내지는 않는다.
LEVEL 2에서 사용한 메시지의 State정보만을 보내준다.
온도, 습도 메시지 따로 전송

myhome/room2/dht22_t: {temperature} (float)
myhome/room2/dht22_h: {humidity} (float)
myhome/room2/gas: {gas} (integer)
myhome/room1/door: {“DoorOpen” or “DoorClosed”} (string)
myhome/room1/flame: {“FlameFlagOn” or “FlameFlagOff”} (string)
myhome/room1/mode: {“LeavingModeON” or “LeavingModeOFF”} (string)
myhome/wifi: {“Connected”} (string)
- mqtt는 internet이 연결되어야 사용할 수 있으므로, Connected 되었을 경우에만 publish 하여 연결 상태를 확인할 수 있도*록 한다.

## Slide 39

HASS: 명세

03

IoT 시스템 설계 – 무성 종합 경보기

Hass

Subscriber

NodeMCU #1
<거실, Room1>

NodeMCU #2
<침실, Room2>

Publisher

Publisher

main

Internet

Internet

MQTT

Raspberry Pi3

Broker

인터넷 미 연결 표시
최근 데이터 지속 표시

Notes: 3개의 탭으로 구성(main, Node#1 상세, node#2 상세)

Internet 조건
- 연결 시, PI broker를 통해 mqtt topic subscribe
- 미 연결 시, 인터넷이 미 연결 되어 있음을 표시해주고 가장 최근 데이터를 지속적으로 표시

Node에서 publish한 data를 수신하여 HASS 내부 데이터 구성

## Slide 40

HASS: mqtt subscribe에 따른 내부 data 정의

03

IoT 시스템 설계 – 무성 종합 경보기

Topic of the data | HASS
myhome/room2/dht22_t | Temperature
Myhome/room2/dht22_h | Humidity
myhome/room2/gas | Gas
myhome/room1/door | Door
myhome/room1/flame | Flame
myhome/room1/mode | Mode
myhome/room1/wifi myhome/room2/wifi2 | Wifi#1 / Wifi#2 Wifi value는 default로 “Disonnected”, mqtt로 연결되어 위 topic이 publish 됐을 때만 “Connected”

## Slide 41

HASS: main Tap – 구조

00

IoT 시스템 설계 – 무성 종합 경보기

Hass

main

(1) Wi-Fi 연결 상태 (#1 / #2)

(2) 온도와 습도

(3) 각 방의 상황

(5) 스위치

## Slide 42

IoT 시스템 설계 – 무성 종합 경보기

THANK
YOU

감사합니다
