areum514/homeIotSystem/diagram/node2_FLAGCHART.jpg

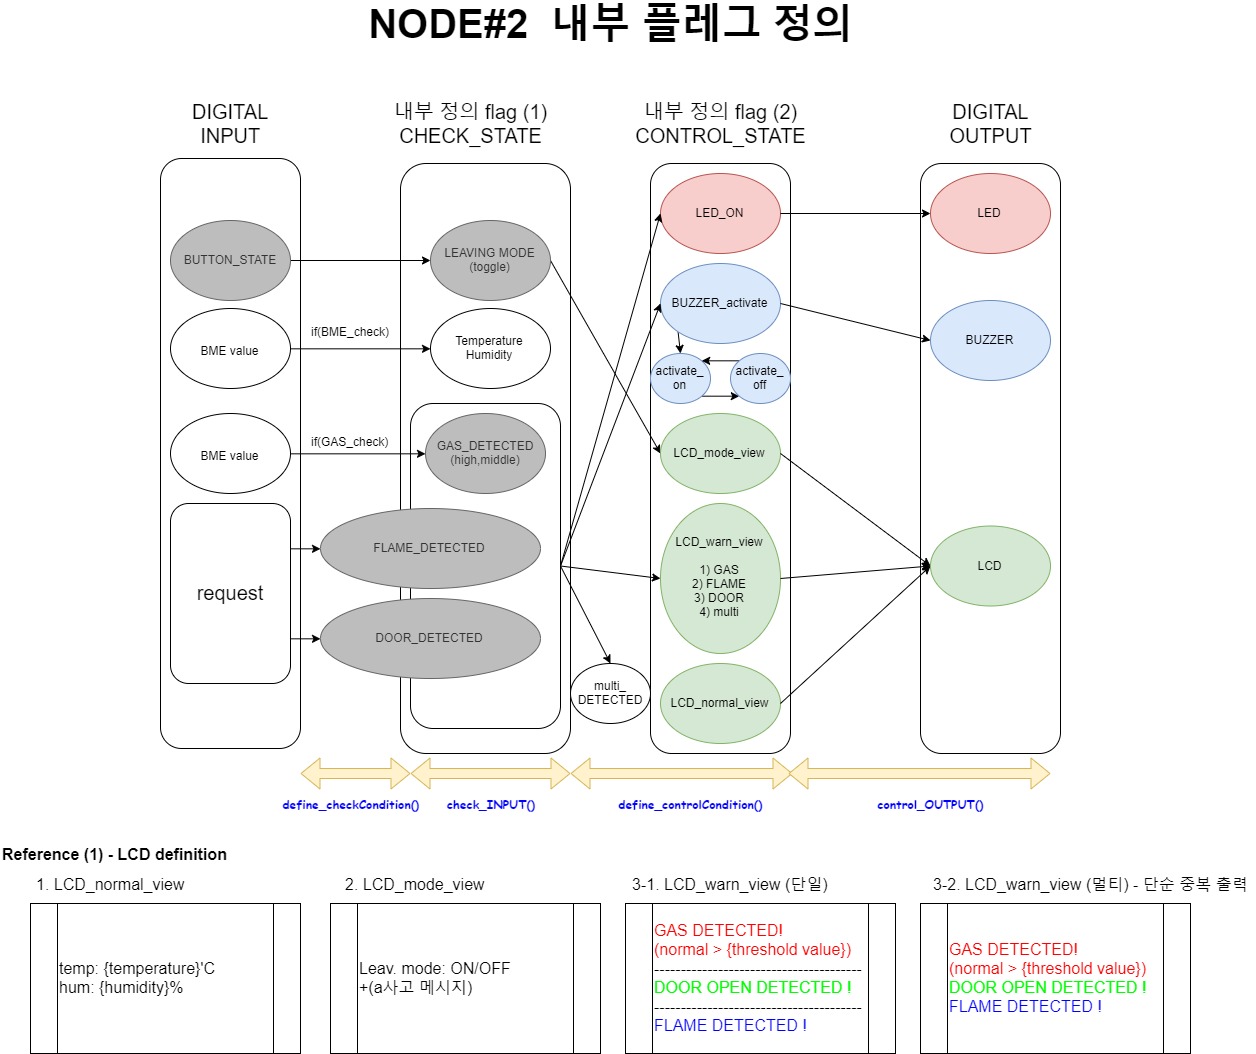
diagram/node2_FLAGCHART.jpg
